cmdwtf/AuraBauble/AuraBauble.kicad_pcb

## KiCad design AuraBauble.kicad_pcb (2020-09-15)

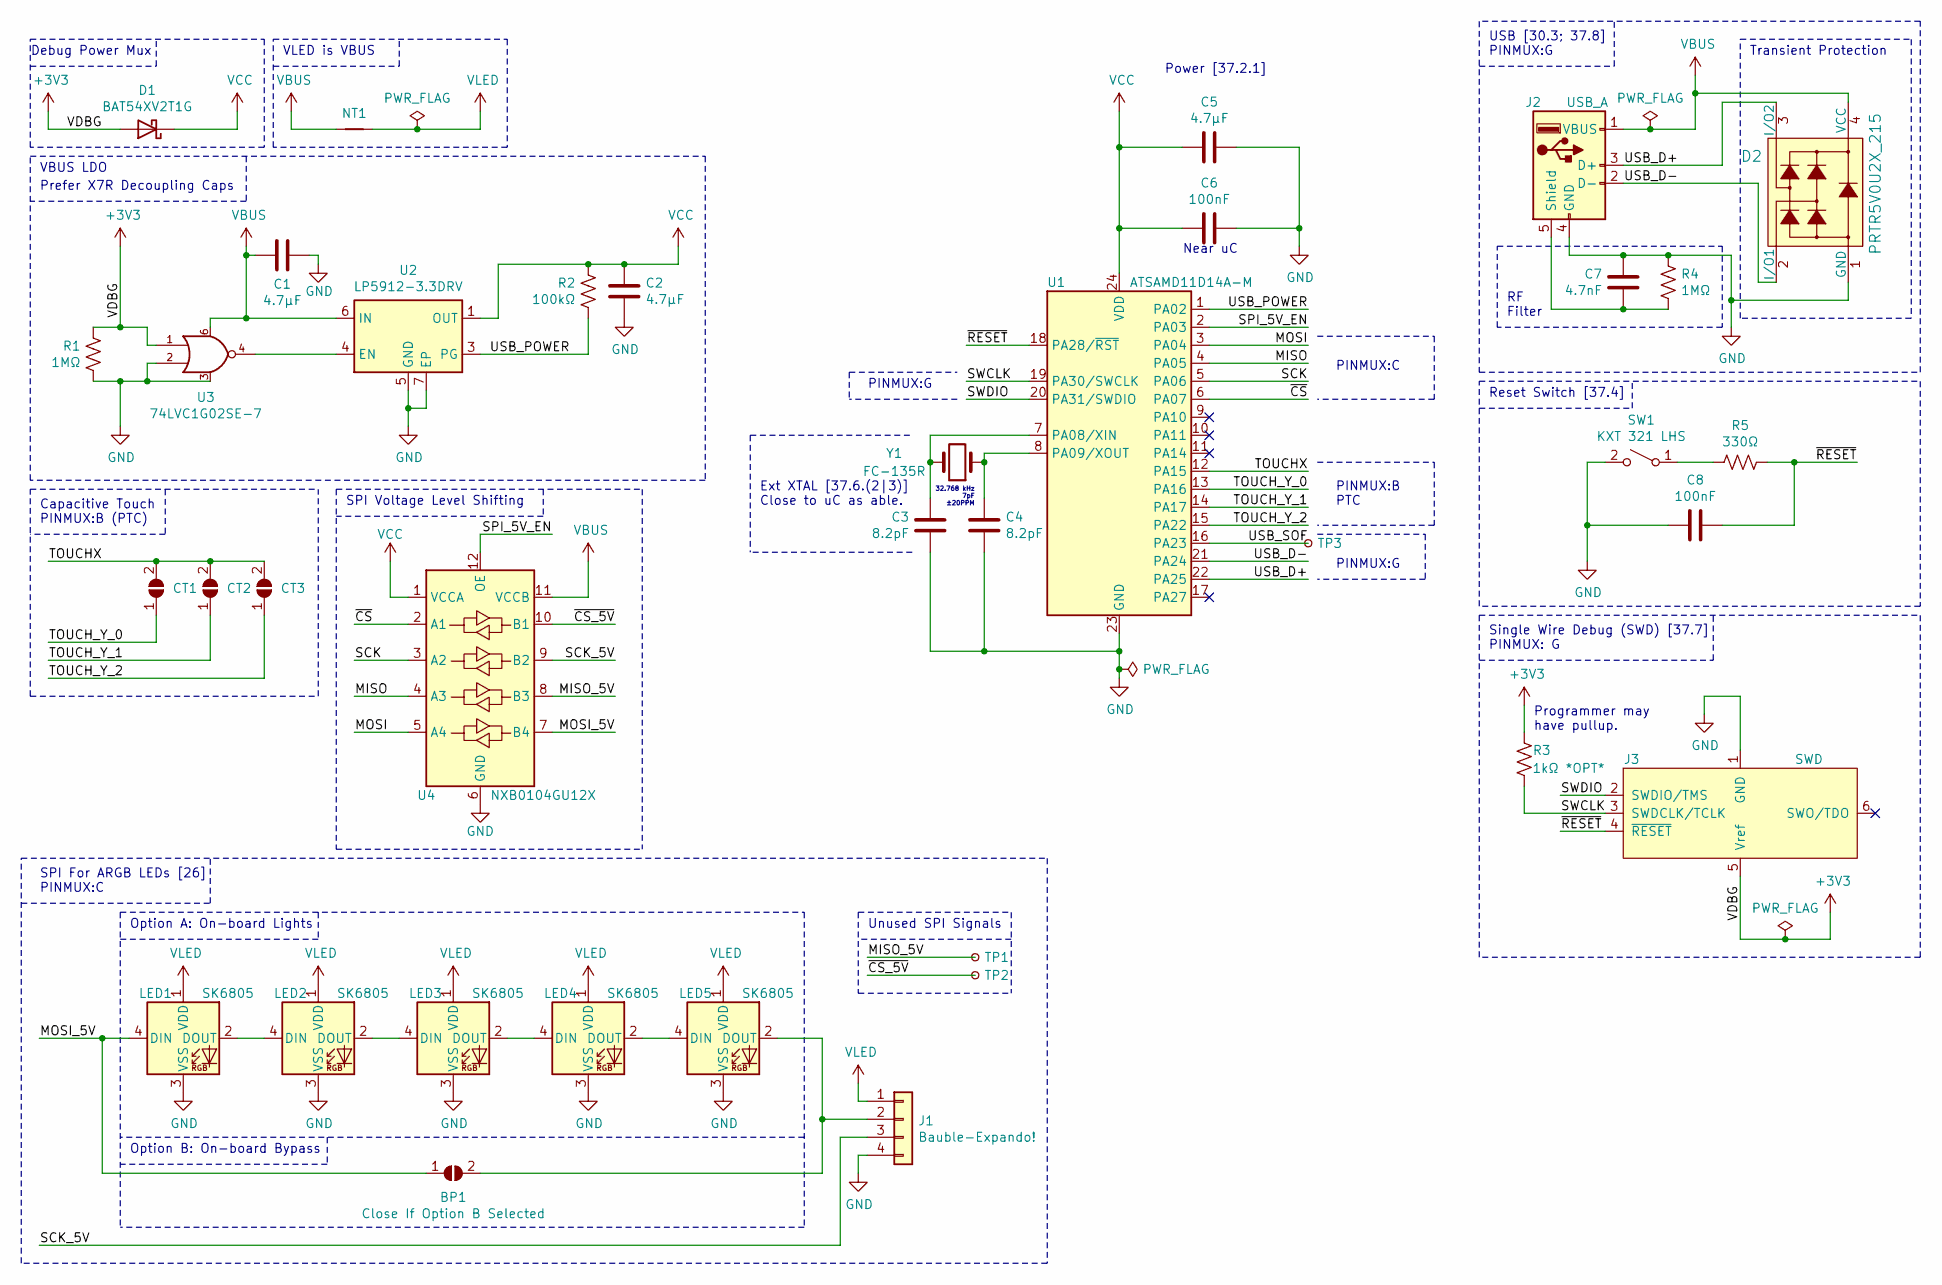
[picture p1: schematic AuraBauble.sch, Aura Bauble]

Parts:
BP1: Close If Option B Selected; SolderJumper-2_P1.3mm_Open_TrianglePad1.0x1.5mm
C1, C2, C5: 4.7µF; C_0402_1005Metric
C3, C4: 8.2pF; C_0402_1005Metric
C6, C8: 100nF; C_0402_1005Metric
C7: 4.7nF; C_0402_1005Metric
CT1, CT2, CT3: CT_Capacitive_Touch_Point_2; SolderJumper-2_P1.3mm_Open_RoundedPad1.0x1.5mm
D1: BAT54XV2T1G; D_SOD-523; Digi-Key BAT54XV2T1GOSCT-ND
D2: PRTR5V0U2X_215; TO-253-4; MPN PRTR5V0U2X,215; Digi-Key_PN 1727-3884-1-ND
J1: Bauble-Expando!; BaubleExpando
J2: USB_A; USB_A_Plug_Edge
J3: SWD; DebugEdge_2x03_Target
LED1, LED2, LED3, LED4, LED5: SK6805; LED_SK6812_EC15_1.5x1.5mm
NT1: Net-Tie_2; NetTie-2_THT_Pad1.0mm
R1, R4: 1MΩ; R_0402_1005Metric
R2: 100kΩ; R_0402_1005Metric
R3: 1kΩ *OPT*; R_0402_1005Metric
R5: 330Ω; R_0402_1005Metric
SW1: KXT 321 LHS; SW_SPST_CK_KXT3; Digi-Key CKN10778CT-ND
TP1, TP2, TP3: TestPoint_Small; TestPoint_Pad_D1.0mm
U1: ATSAMD11D14A-M; QFN-24-1EP_4x4mm_P0.5mm_EP2.6x2.6mm; Digi-Key ATSAMD11D14A-MUTCT-ND
U2: LP5912-3.3DRV; WSON-6-1EP_2x2mm_P0.65mm_EP1x1.6mm_ThermalVias; Digi-Key 296-44153-1-ND
U3: 74LVC1G02SE-7; SOT-363_SC-70-6; Digi-Key 74LVC1G02SE-7DICT-ND
U4: NXB0104GU12X; XQFN12; Digi-Key 1727-NXB0104GU12XCT-ND
Y1: FC-135R; Crystal_SMD_3215-2Pin_3.2x1.5mm; Digi-Key FC-135 32.7680KA-AG5

Connections:
+3V3: D1.2 (A), J3.5 (Vref), R1.2, R3.2, U3.1
/MISO: U1.4 (PA05), U4.4 (A3)
/MISO_5V: TP1.1, U4.8 (B3)
/MOSI: U1.3 (PA04), U4.5 (A4)
/MOSI_5V: BP1.1 (A), LED1.4 (DIN), U4.7 (B4)
/SCK: U1.5 (PA06), U4.3 (A2)
/SCK_5V: J1.3, U4.9 (B2)
/SPI_5V_EN: U1.2 (PA03), U4.12 (OE)
/SWCLK: J3.3 (SWDCLK/TCLK), R3.1, U1.19 (PA30/SWCLK)
/SWDIO: J3.2 (SWDIO/TMS), U1.20 (PA31/SWDIO)
/TOUCHX: CT1.2 (B), CT2.2 (B), CT3.2 (B), U1.12 (PA15)
/TOUCH_Y_0: CT1.1 (A), U1.13 (PA16)
/TOUCH_Y_1: CT2.1 (A), U1.14 (PA17)
/TOUCH_Y_2: CT3.1 (A), U1.15 (PA22)
/USB_D+: D2.3 (I/O2), J2.3 (D+), U1.22 (PA25)
/USB_D-: D2.2 (I/O1), J2.2 (D-), U1.21 (PA24)
/USB_POWER: R2.2, U1.1 (PA02), U2.3 (PG)
/USB_SOF: TP3.1, U1.16 (PA23)
/~CS_5V~: TP2.1, U4.10 (B1)
/~CS~: U1.6 (PA07), U4.2 (A1)
/~RESET~: C8.1, J3.4 (~RESET~), R5.1, U1.18 (PA28/~RST)
GND: C1.2, C2.1, C3.2, C4.2, C5.1, C6.1, C7.1, C8.2, D2.1 (GND), J1.4, J2.4 (GND), J3.1 (GND), LED1.3 (VSS), LED2.3 (VSS), LED3.3 (VSS), LED4.3 (VSS), LED5.3 (VSS), R1.1, R4.2, SW1.2 (B), U1.23 (GND), U2.5 (GND), U2.7 (EP), U3.2, U3.3 (GND), U4.6 (GND)
unnamed: BP1.2 (B), J1.2, LED5.2 (DOUT)
unnamed: C3.1, U1.7 (PA08/XIN), Y1.2
unnamed: C4.1, U1.8 (PA09/XOUT), Y1.1
unnamed: C7.2, J2.5 (Shield), R4.1
unnamed: LED1.2 (DOUT), LED2.4 (DIN)
unnamed: LED2.2 (DOUT), LED3.4 (DIN)
unnamed: LED3.2 (DOUT), LED4.4 (DIN)
unnamed: LED4.2 (DOUT), LED5.4 (DIN)
unnamed: R5.2, SW1.1 (A)
unnamed: U2.4 (EN), U3.4
VBUS: C1.1, D2.4 (VCC), J2.1 (VBUS), NT1.1, U2.6 (IN), U3.6 (VCC), U4.11 (VCCB)
VCC: C2.2, C5.2, C6.2, D1.1 (K), R2.1, U1.24 (VDD), U2.1 (OUT), U4.1 (VCCA)
VLED: J1.1, LED1.1 (VDD), LED2.1 (VDD), LED3.1 (VDD), LED4.1 (VDD), LED5.1 (VDD), NT1.2

Notes on the sheet:
Power [37.2.1]
Reset Switch [37.4]
USB [30.3; 37.8] PINMUX:G
Near uC
Single Wire Debug (SWD) [37.7] PINMUX: G
RF Filter
Transient Protection
Programmer may have pullup.
Debug Power Mux
PINMUX:C
PINMUX:G
Ext XTAL [37.6.(2|3)] Close to uC as able.
Prefer X7R Decoupling Caps
VBUS LDO
VLED is VBUS
32.768 kHz 7pF ±20PPM
PINMUX:B PTC
Capacitive Touch PINMUX:B (PTC)
Unused SPI Signals
Option B: On-board Bypass
Option A: On-board Lights
SPI Voltage Level Shifting
SPI For ARGB LEDs [26] PINMUX:C

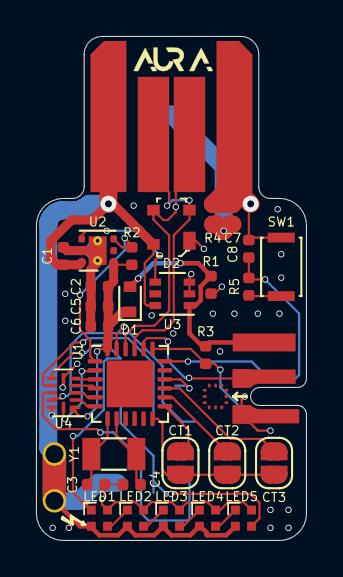
[picture p2: board AuraBauble.kicad_pcb from above]

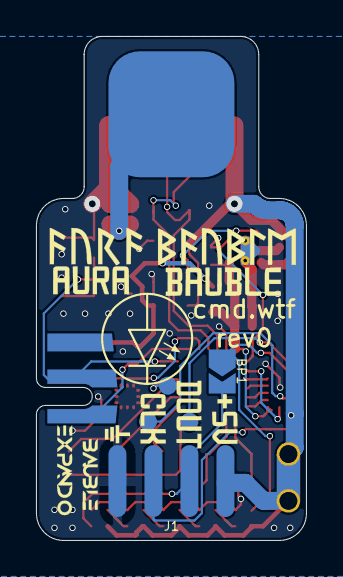
[picture p3: board AuraBauble.kicad_pcb from below]

Board: 2 copper layers, 15.0 x 28.0 mm, 37 parts (5 on the bottom side), 35 nets.
