cmdwtf/AuraBauble/(threads)

Thread 3 (2021-01-24):

Drop reset button

nitz, 2021-01-24:
The button chosen is too small to be useful, and a TH sized via near ground would be more useful for resetting.

Thread 5 (2021-01-24):

Shield pad doesn't touch most ports shield tabs

nitz, 2021-01-24:
Most of the ports/cables I have use a pair of tabs to make shield contact, spread just slightly larger than the pad.

Thread 6 (2021-01-24):

USB tip too small for most ports.

nitz, 2021-01-24:
Except for overly aggressive ports, the PCB is just slightly too small.

Compared to the [nRF52840 USB Dongle](https://www.nordicsemi.com/Software-and-tools/Development-Kits/nRF52840-Dongle), the overall PCB width seems to be about 0.2mm or so thinner. Additionally, the Nordic dongle goes wider as it knows it doesn't have a shield. That likely helps a lot, reaching the physical limits of most USB ports easier.
