cmdwtf/AuraBauble/(commit log)

2020-09-12 ATSAMD11D14A core laid out.
    No other comms but USB yet.
    [AuraBauble.kicad_pcb, AuraBauble.sch]
2020-09-12 Switched Zener Diodes to a PRTR5V0U2X
    [AuraBauble.sch]
2020-09-12 Power work.
    [AuraBauble.sch]
2020-09-13 Schematic nearly r0.
    [AuraBauble.sch]
2020-09-13 Moved to the QFN SAMD.
    Looks like oshpark can't do the tolerances for the WLCSP.
    Gave it my all trying to route it as a 2-layer, but doesn't look like I can do it and stay as tiny as I want. Tomorrow we'll go 4 layer.
    [AuraBauble.kicad_pcb, AuraBauble.sch]
2020-09-13 Removed some test points.
    Also flipped the uC, because somehow it flipped?
    [AuraBauble.sch]
2020-09-14 Added TP for USB SOF.
    [AuraBauble.sch]
2020-09-14 Closing in on a rev0.
    I still think I need to level shift the SPI signals to the LEDs.
    [AuraBauble.kicad_pcb, AuraBauble.sch]
2020-09-14 Crammed a level shifter in, added fifth LED.
    [AuraBauble.kicad_pcb, AuraBauble.sch]
2020-09-15 3d Shapes!
    [AuraBauble.kicad_pcb]
2020-09-15 Update some annotations.
    [AuraBauble.kicad_pcb, AuraBauble.sch]
2020-09-15 Somebody had SWDIO/SWCLK swapped.
    It's me. I'm somebody.
    [AuraBauble.kicad_pcb, AuraBauble.sch]
2020-09-15 Trying to clarify which pin is power for SK6805s.
    [AuraBauble.kicad_pcb]
2020-09-15 Move BP1 a bit so it doesn't collide with expando silk.
    [AuraBauble.kicad_pcb]
2020-09-15 Cleanup some C & R values.
    Adjusted C7 up slightly based on parts available. R1 moved from 100 MOhms to 1 MOhm to line up part with R4.
    [AuraBauble.kicad_pcb, AuraBauble.sch]
